beeg-projects/HiGrow2/docs/README.md

# docs

Documentazione di supporto al progetto HiGrow 2.0.

* [jlcpcb-kicad-workflow.md](jlcpcb-kicad-workflow.md): come lavorare in KiCad
  con i componenti JLCPCB (assegnazione codici LCSC, verifica stock,
  generazione dei file di fabbricazione e di assembly).

Qui vanno anche i datasheet dei componenti principali (BQ25798, DW01A,
FS8205A, ESP32-C6, ecc.) e le immagini/diagrammi richiamati dal readme.
