beeg-projects/HiGrow2/(commit log)

2026-06-25 Rewrite readme with HiGrow 2.0 hardware architecture and BOM
2026-06-25 Scaffold KiCad project structure, draft BOM and JLCPCB workflow
    [bom_draft.csv]
2026-06-25 Add empty KiCad 10 project (schematic + 2-layer PCB)
    [HiGrow2.kicad_pcb, HiGrow2.kicad_sch]
2026-06-25 Add soil temperature sensing (NTC on probe) to spec and BOM
    [bom_draft.csv]
